silasloeffler/SmartPlant_ESP32/documentation/calibration.jpg

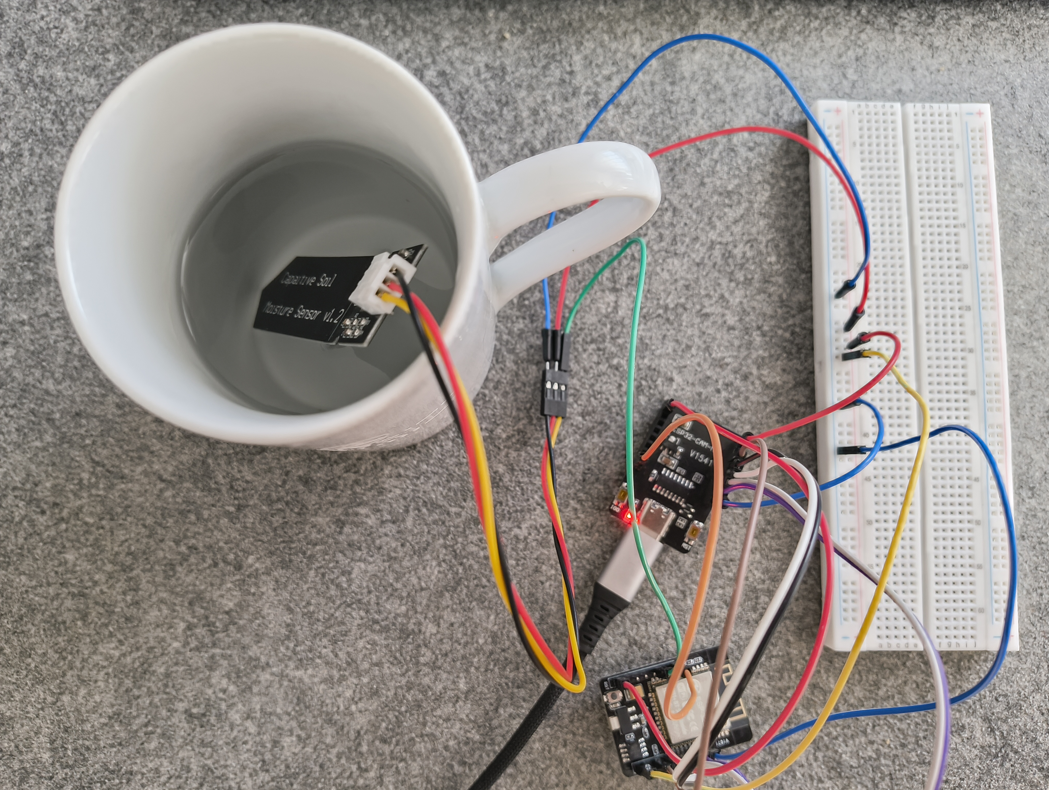
documentation/calibration.jpg
