silasloeffler/SmartPlant_ESP32/documentation/live_testing.jpg

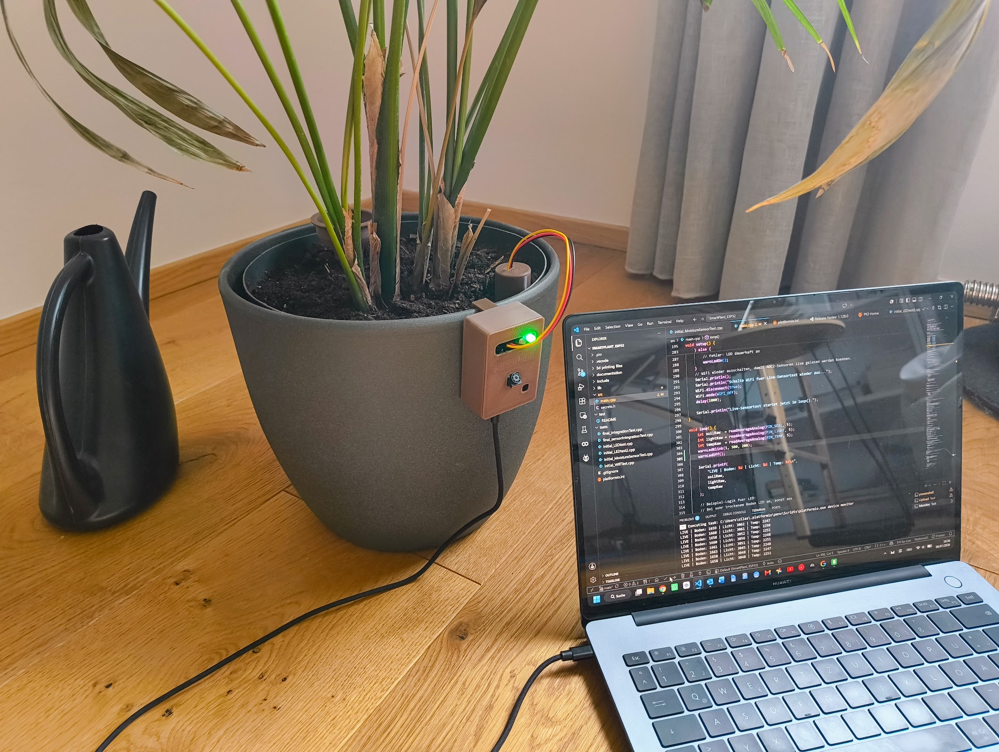
documentation/live_testing.jpg
