silasloeffler/SmartPlant_ESP32/documentation/case_CAD.png

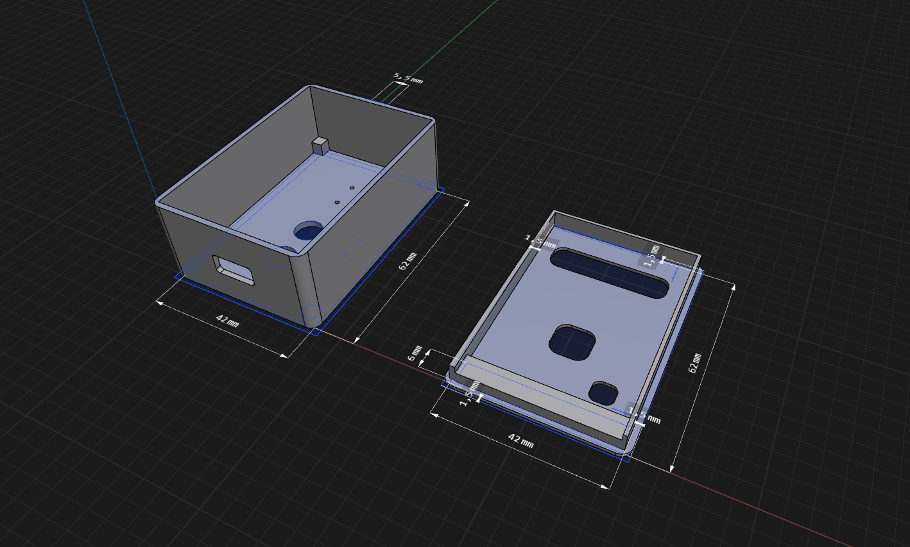
documentation/case_CAD.png
