silasloeffler/SmartPlant_ESP32/documentation/case_CAD_fullscreen.png

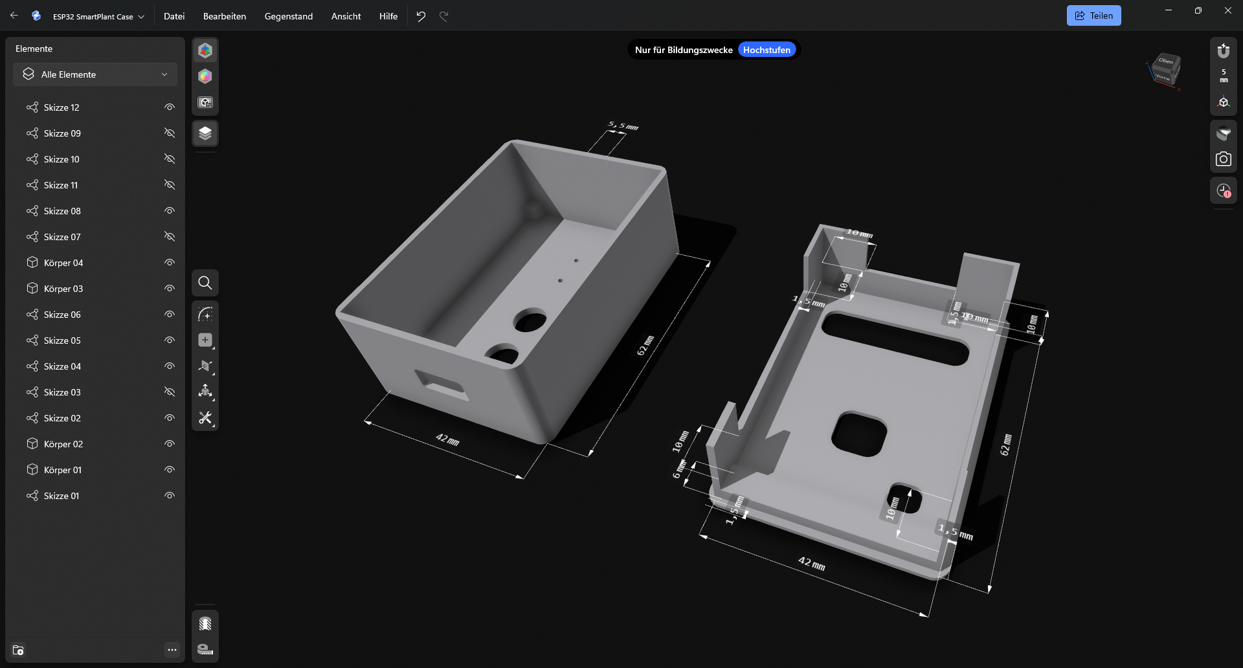
documentation/case_CAD_fullscreen.png
