silasloeffler/SmartPlant_ESP32/documentation/case_CAD_visualized.png

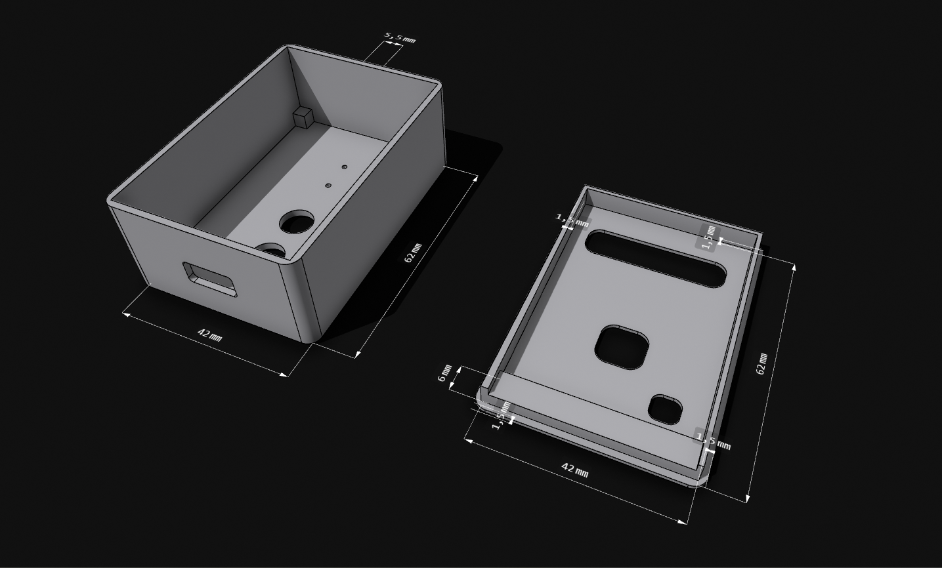
documentation/case_CAD_visualized.png
