silasloeffler/SmartPlant_ESP32/documentation/final case.jpg

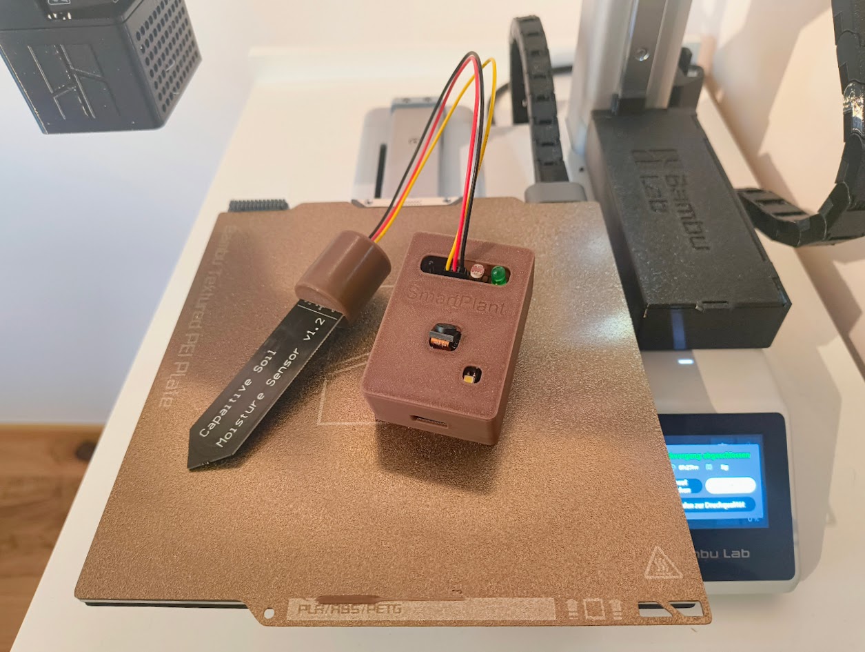
documentation/final case.jpg
