silasloeffler/SmartPlant_ESP32/documentation/last_received.jpg

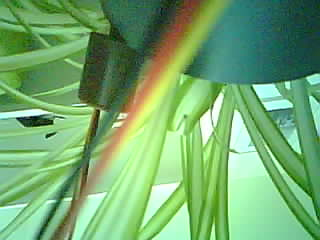
documentation/last_received.jpg
