silasloeffler/SmartPlant_ESP32/documentation/Pin Übersicht.jpg

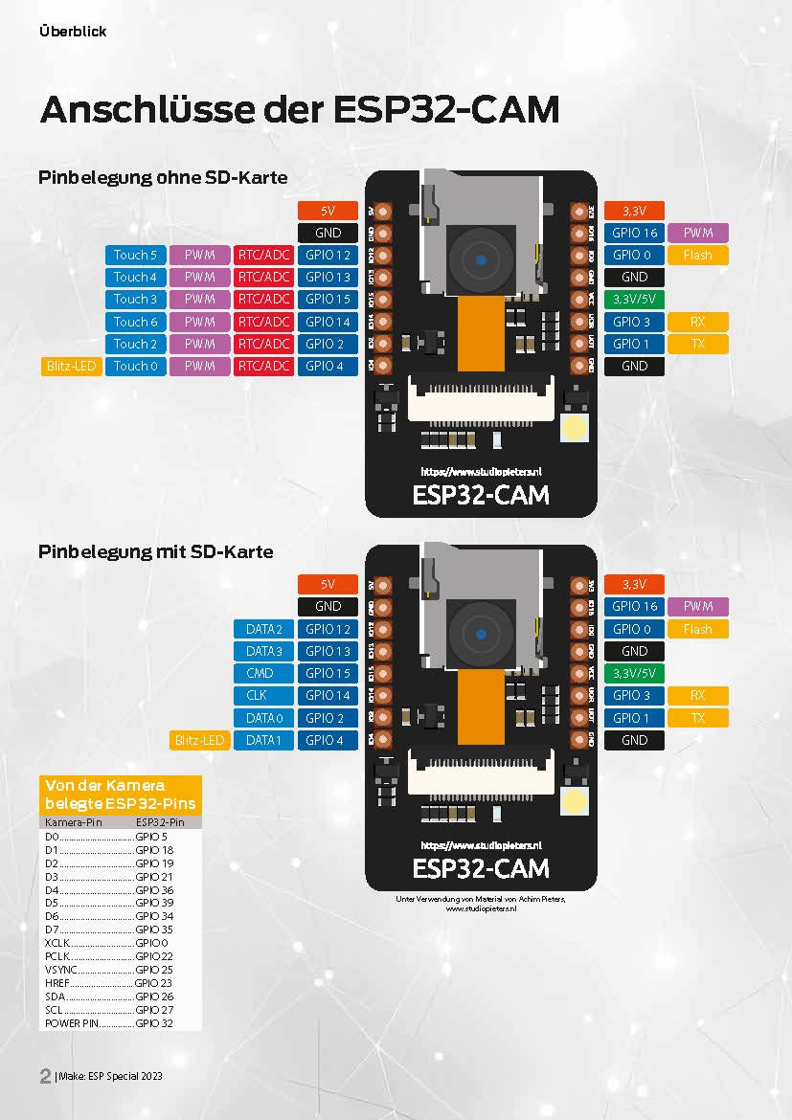
documentation/Pin Übersicht.jpg
