silasloeffler/SmartPlant_ESP32/documentation/Screenshot 2026-07-03 162201.png

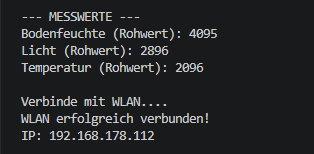
documentation/Screenshot 2026-07-03 162201.png
