silasloeffler/SmartPlant_ESP32/documentation/sensor integration.jpg

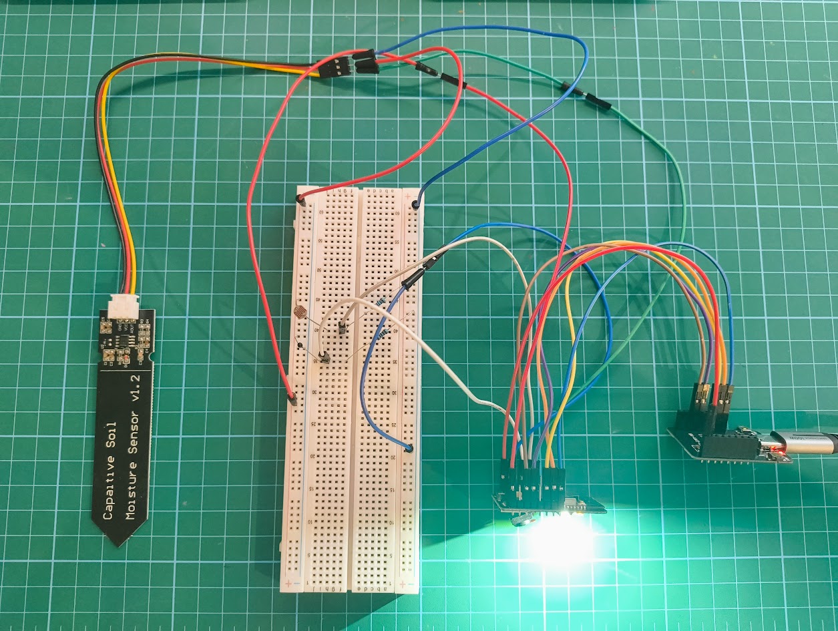
documentation/sensor integration.jpg
