silasloeffler/SmartPlant_ESP32/3d printing files/case_bottom.stl

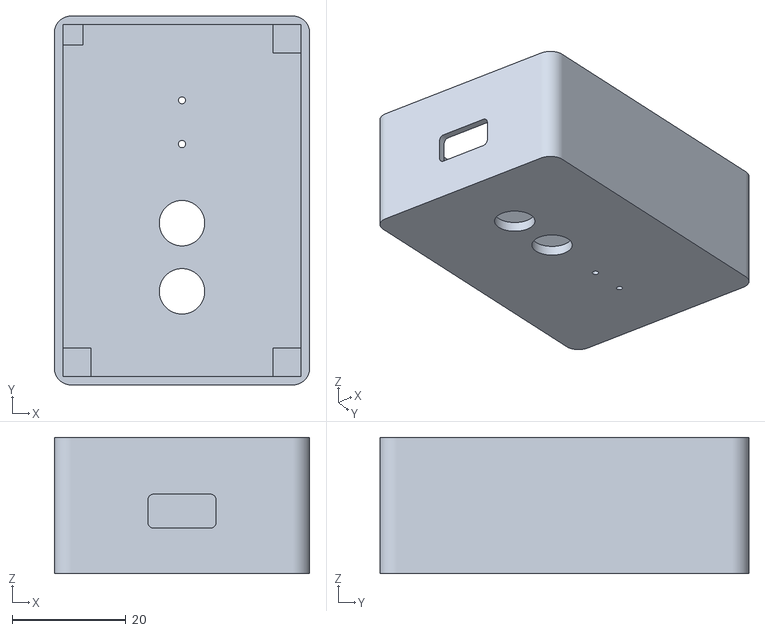
[picture p11: CAD file, 2026-07-08]
3d printing files/case_bottom.stl
45.0 x 65.0 x 24.0
