silasloeffler/SmartPlant_ESP32/3d printing files/case_top.3mf

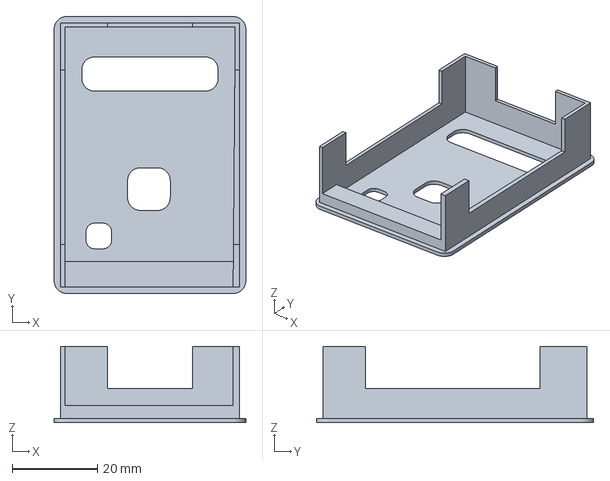
[picture p12: CAD file, 2026-07-08]
3d printing files/case_top.3mf
45.0 x 65.0 x 17.9 mm
