silasloeffler/SmartPlant_ESP32/3d printing files/capacitive_moisture_sensor.3mf

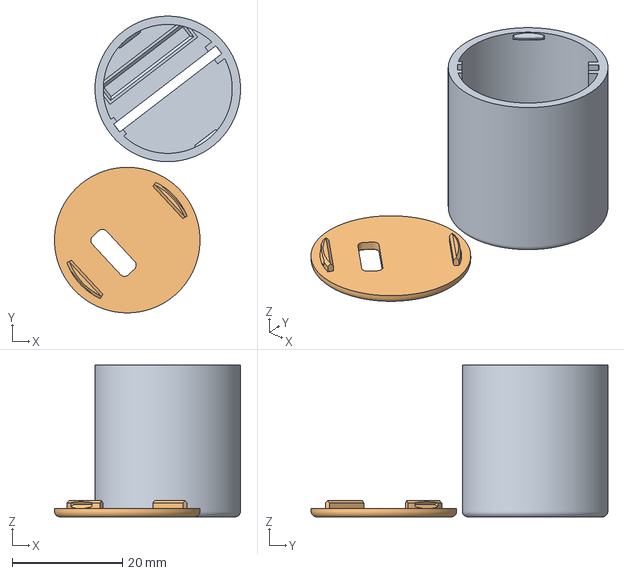
[picture p13: CAD file, 2026-07-08]
3d printing files/capacitive_moisture_sensor.3mf
33.7 x 53.8 x 27.5 mm
moisture_body.stl
moisture_lid.stl
