silasloeffler/SmartPlant_ESP32/3d printing files/Haken_zum_schrauben.3mf

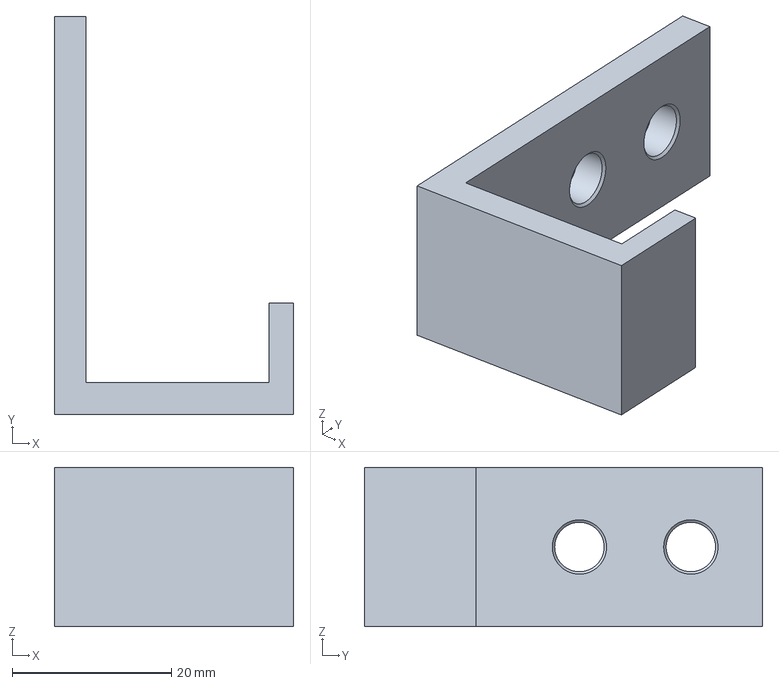
[picture p14: CAD file, 2026-07-08]
3d printing files/Haken_zum_schrauben.3mf
30.1 x 50.0 x 20.0 mm
