silasloeffler/SmartPlant_ESP32/(list of files, cad)

Other CAD files:
3d printing files/bottom_case.3mf
3d printing files/case_top.stl
