silasloeffler/SmartPlant_ESP32/documentation/3d printing.jpg

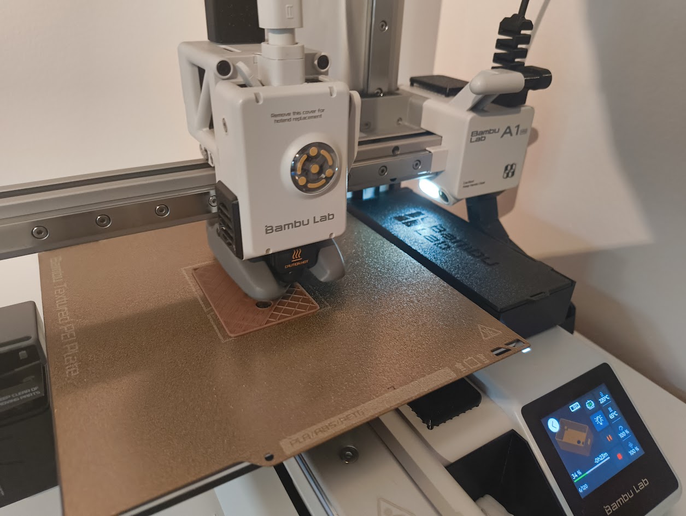
documentation/3d printing.jpg
