silasloeffler/SmartPlant_ESP32/documentation/final hardware setup.jpg

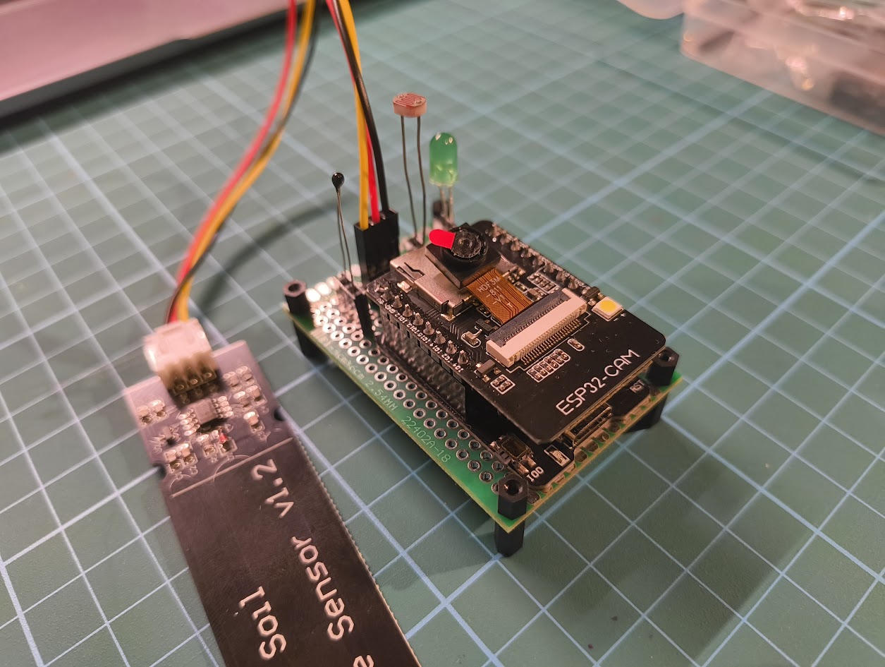
documentation/final hardware setup.jpg
