silasloeffler/SmartPlant_ESP32/documentation/soldering.jpg

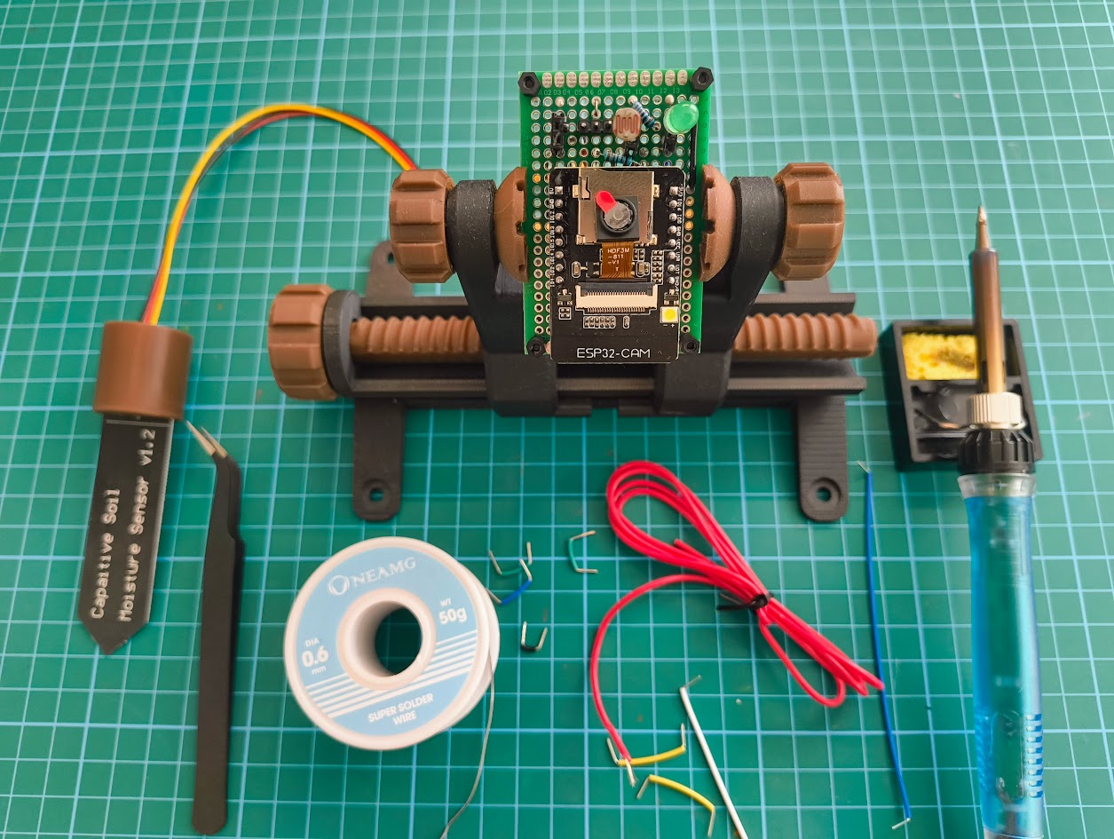
documentation/soldering.jpg
