silasloeffler/SmartPlant_ESP32/documentation/soldering_test_serialmonitor.png

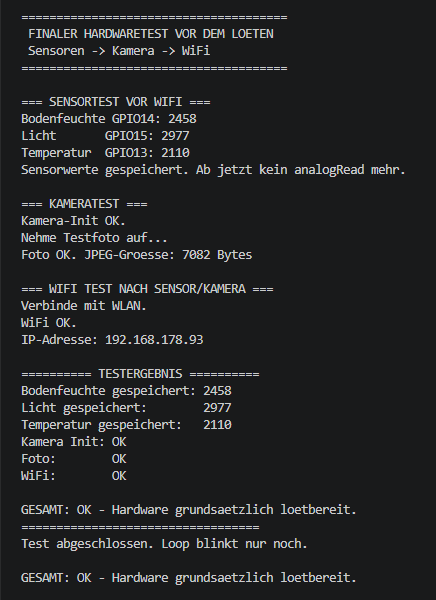
documentation/soldering_test_serialmonitor.png
