silasloeffler/SmartPlant_ESP32/documentation/Live Sensor Test.png

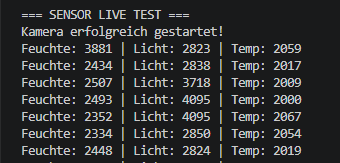
documentation/Live Sensor Test.png
