silasloeffler/SmartPlant_ESP32/documentation/sensor testing.jpg

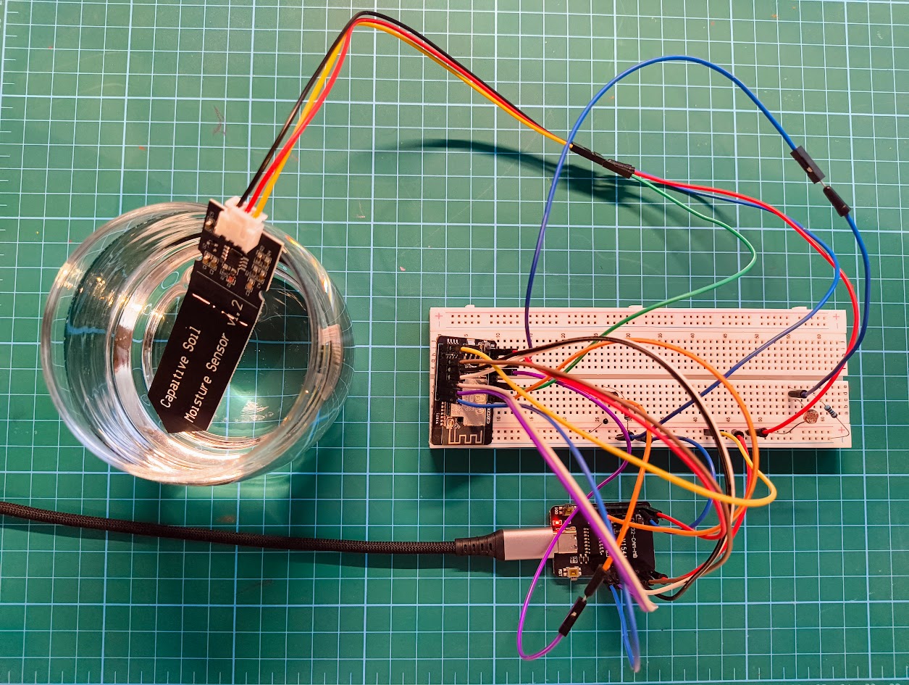
documentation/sensor testing.jpg
