silasloeffler/SmartPlant_ESP32/schematics/Schematic_SmartPlant_2026-07-18.pdf

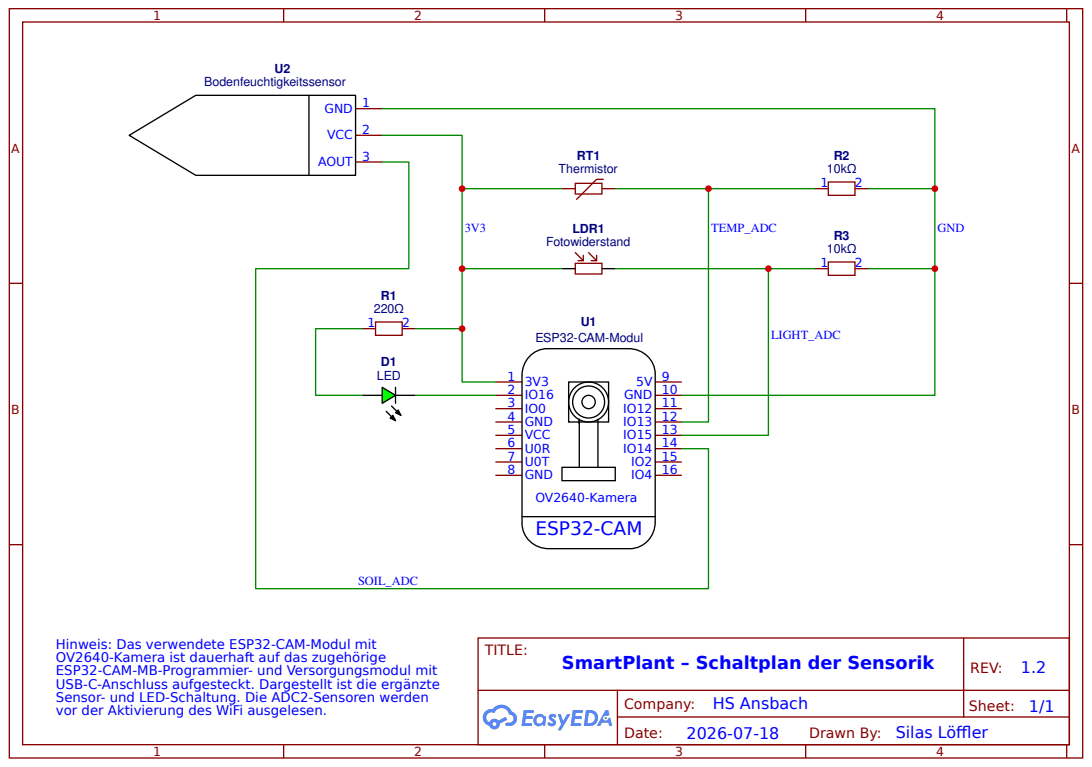
[picture p21: page 1]
ESP32-CAM-Modul; ESP32-CAM; 3V3 1 IO16 2 IO0 3 GND 4 VCC 5 U0R 6 U0T 7 GND 8; GND; Bodenfeuchtigkeitssensor; GND 1; VCC 2; AOUT 3; Thermistor; Fotowiderstand; LDR1; LED; SOIL_ADC; LIGHT_ADC; TEMP_ADC; TITLE:; SmartPlant – Schaltplan der Sensorik; REV: 1.2; Date:; Sheet: 1/1; OV2640-Kamera

Hinweis: Das verwendete ESP32-CAM-Modul mit
OV2640-Kamera ist dauerhaft auf das zugehörige
ESP32-CAM-MB-Programmier- und Versorgungsmodul mit
USB-C-Anschluss aufgesteckt. Dargestellt ist die ergänzte
Sensor- und LED-Schaltung. Die ADC2-Sensoren werden
vor der Aktivierung des WiFi ausgelesen.

Company: HS Ansbach

Drawn By: Silas Löffler
