silasloeffler/SmartPlant_ESP32/(list of files, drawings)

Other design files:
schematics/Schematic_SmartPlant_2026-07-18.json
