silasloeffler/SmartPlant_ESP32/(commit log)

2026-07-02 Initial commit: ESP32-CAM basic setup and sensor test environment
2026-07-02 Moisture sensor works
2026-07-03 Hardware (sensors and Wifi) integration test
2026-07-07 Final test before soldering
2026-07-07 add status LED and verify soldering
2026-07-08 3d printing and soldering documentation
    [Haken_zum_schrauben.3mf, bottom_case.3mf, capacitive_moisture_sensor.3mf, case_bottom.stl, case_top.3mf, case_top.stl]
2026-07-18 add SmartPlant sensor schematic
2026-07-21 final schematics upload
    [Schematic_SmartPlant_2026-07-18.json]
